openUC2/openUC2-OT2-PlateGripper/README.md

# Opentrons OT-2 Gripper

This is a starting point to develop an open-source plate gripper for the OT2. It uses a NEMA8 captive stepper motor and the beloved MGN9 linear rails. + screws + 3D printing + <3. 

More comming soon! 

## In action
