openUC2/openUC2-OT2-PlateGripper/INVENTOR/OT2-Gripper V1-1 BG_OT2-Gripper V1-1 - linear-adapter_3.stl

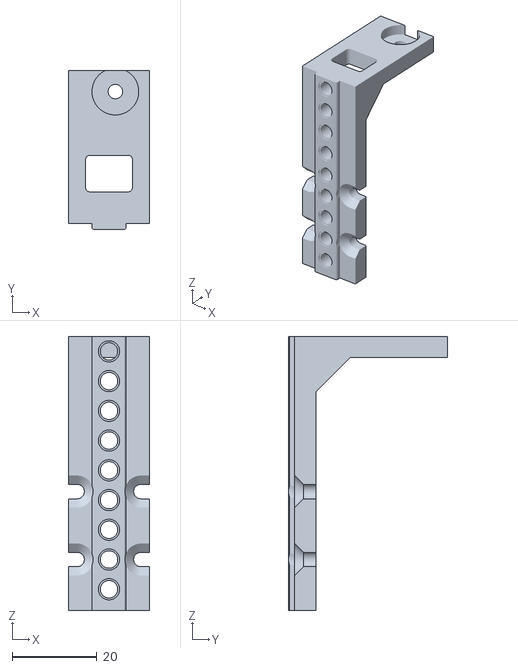
[picture p2: CAD file, 2024-09-13]
INVENTOR/OT2-Gripper V1-1 BG_OT2-Gripper V1-1 - linear-adapter_3.stl
19.0 x 37.5 x 64.5
