openUC2/openUC2-OT2-PlateGripper/INVENTOR/OT2-Gripper V1-1 BG_OT2-Gripper V1-1 - linear adapter static_2.stl

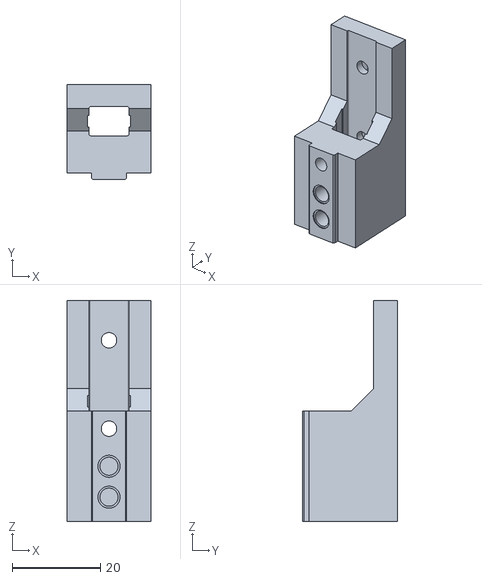
[picture p3: CAD file, 2024-09-13]
INVENTOR/OT2-Gripper V1-1 BG_OT2-Gripper V1-1 - linear adapter static_2.stl
19.0 x 21.5 x 50.0
