openUC2/openUC2-OT2-PlateGripper/INVENTOR/OT2-Gripper V1-1 BG_OT2-Gripper V1-1 - gripper A_4.stl

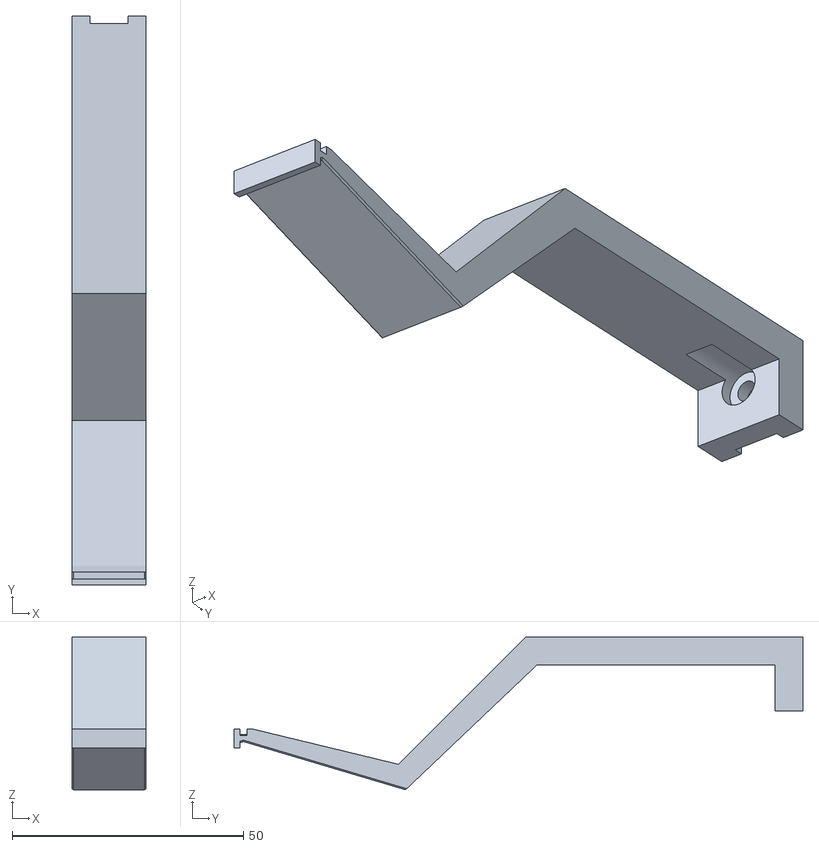
[picture p4: CAD file, 2024-09-13]
INVENTOR/OT2-Gripper V1-1 BG_OT2-Gripper V1-1 - gripper A_4.stl
16.0 x 123.0 x 33.0
