openUC2/openUC2-OT2-PlateGripper/INVENTOR/OT2-Gripper V1-1 BG_OT2-Gripper V1-1 - OT2-interface adapter_1.stl

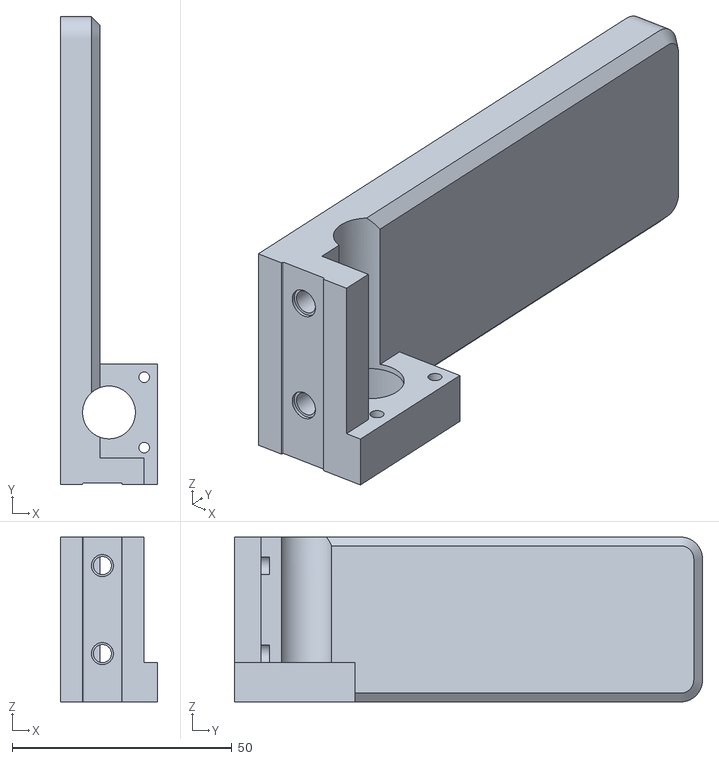
[picture p5: CAD file, 2024-09-13]
INVENTOR/OT2-Gripper V1-1 BG_OT2-Gripper V1-1 - OT2-interface adapter_1.stl
22.0 x 106.4 x 37.5
