openUC2/openUC2-OT2-PlateGripper/(list of files, cad)

Other CAD files:
INVENTOR/00_24wellplate_base_2.ipt
INVENTOR/00_Joy-IT-B20SHD4353_NEMA8_captive.ipt
INVENTOR/00_OT-2 Reference_Pipettte.ipt
INVENTOR/00_OT2-Pippette_1.ipt
INVENTOR/Actuator_MGN-BG.iam
INVENTOR/Actuator_MGN9.ipt
INVENTOR/Actuator_MGN9C.ipt
INVENTOR/Assemlby_OT2-Gripper.iam
INVENTOR/OT2-Gripper V1-1 - OT2-interface adapter.ipt
INVENTOR/OT2-Gripper V1-1 - gripper A.ipt
INVENTOR/OT2-Gripper V1-1 - linear adapter static.ipt
INVENTOR/OT2-Gripper V1-1 - linear-adapter.ipt
INVENTOR/OT2-Gripper V1-1 BG Layout.ipt
INVENTOR/OT2-Gripper V1-1 BG.iam
INVENTOR/OT2-Gripper_base.ipt
INVENTOR/OT2-Gripper_block.ipt
INVENTOR/OT2-Gripper_finger.ipt
INVENTOR/OT2-Gripper_slider.ipt
INVENTOR/OldVersions/00_24wellplate_base_2.0003.ipt
INVENTOR/OldVersions/00_Joy-IT-B20SHD4353_NEMA8_captive.0004.ipt
INVENTOR/OldVersions/Actuator_MGN-BG.0002.iam
INVENTOR/OldVersions/Actuator_MGN9.0006.ipt
INVENTOR/OldVersions/Actuator_MGN9C.0007.ipt
INVENTOR/OldVersions/OT2-Gripper V1-1 - OT2-interface adapter.0003.ipt
INVENTOR/OldVersions/OT2-Gripper V1-1 - gripper A.0002.ipt
INVENTOR/OldVersions/OT2-Gripper V1-1 - linear adapter static.0005.ipt
INVENTOR/OldVersions/OT2-Gripper V1-1 - linear-adapter.0005.ipt
INVENTOR/OldVersions/OT2-Gripper V1-1 BG Layout.0025.ipt
INVENTOR/OldVersions/OT2-Gripper V1-1 BG.0020.iam
INVENTOR/Threaded Insert-Ruthex-M3.ipt
INVENTOR/o-ring eg MISUMI NSF12.ipt
