openUC2/openUC2-OT2-PlateGripper/(commit log)

2024-09-11 started work on V1.1
    created baseline layout part with some part-blocks
    [OT2-Gripper V1-1 BG Layout.0004.ipt, OT2-Gripper V1-1 BG Layout.ipt]
2024-09-13 V1-1 finalizing
    ready for print and test
    [00_24wellplate_base_2.0003.ipt, 00_24wellplate_base_2.ipt, 00_Joy-IT-B20SHD4353_NEMA8_captive.0004.ipt, 00_Joy-IT-B20SHD4353_NEMA8_captive.ipt, Actuator_MGN-BG.0002.iam, Actuator_MGN-BG.iam, Actuator_MGN9.0006.ipt, Actuator_MGN9.ipt]
2024-11-14 add stp
    [OT2-Gripper V1-1 BG.0017.iam, OT2-Gripper V1-1 BG.0020.iam, OT2-Gripper V1-1 BG.iam, OT2-Gripper V1-1 BG.stp]
